MacroFab/Macro_Watch/Hardware/Eagle/README.md

###Macro_Watch Hardware
***
**Low cost, binary watch based off the PIC16F527 MCU for promotional purposes at MacroFab, INC.**

***
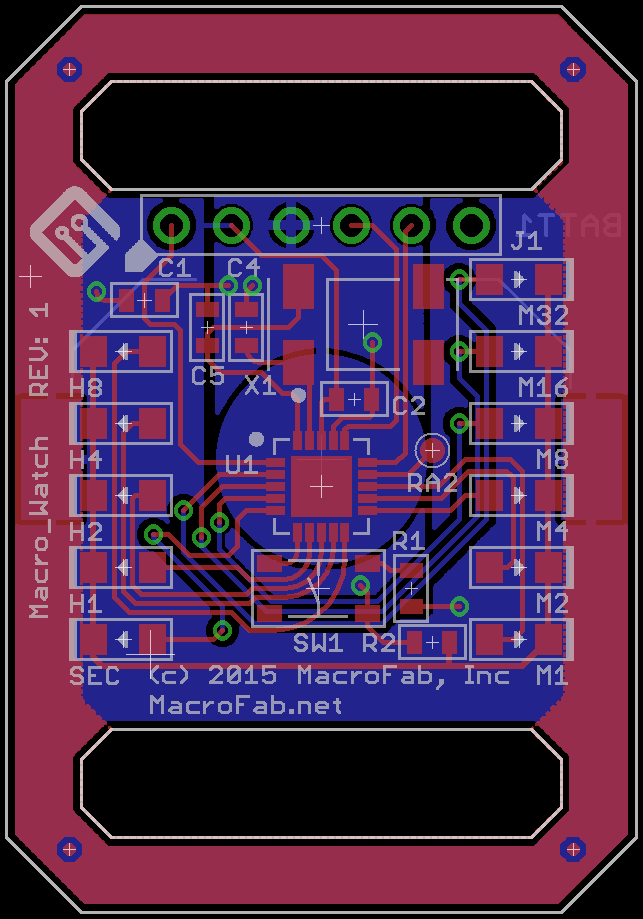
[picture p11: Hardware/Eagle/Layout.png]
Layout Image


***
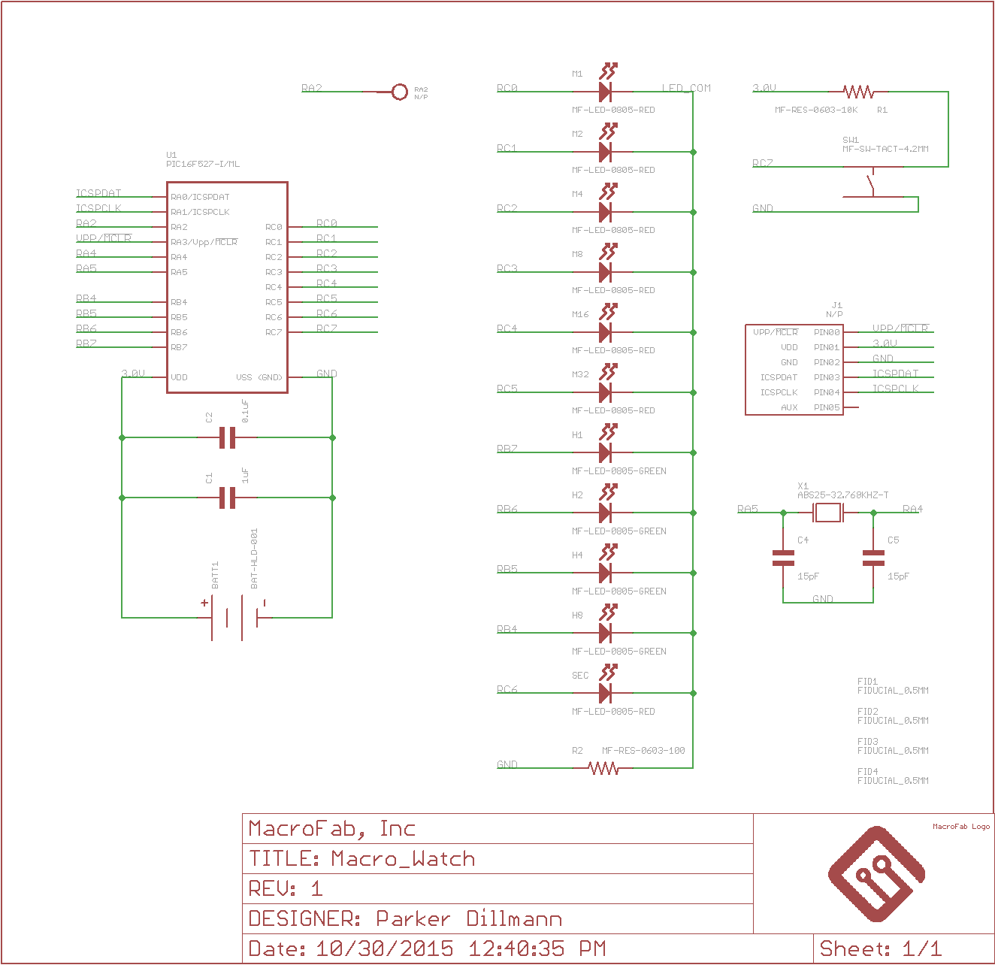
[picture p12: Hardware/Eagle/Schematic.png]
Schematic Image


***
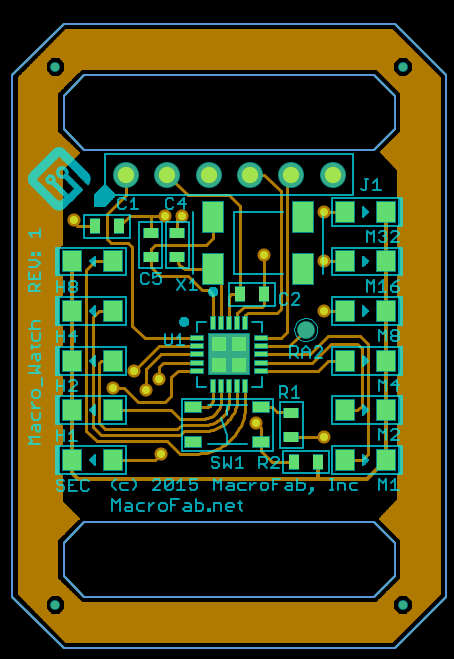
[picture p13: Hardware/Eagle/MacroWatch_gerber.png]
Gerber Top Drawing


Files are for Eagle V6.0+. Gerber files can be found in the camfiles directory. See main directory for licensing.
