MacroFab/Macro_Watch/(list of files, cad)

Other CAD files:
Software/MacroWatch.X/dist/default/production/MacroWatch.X.production.obj
