MacroFab/Macro_Watch/Hardware/Eagle/Macro_Watch.brd

## EAGLE design Hardware/Eagle/Macro_Watch.brd (2015-12-14)

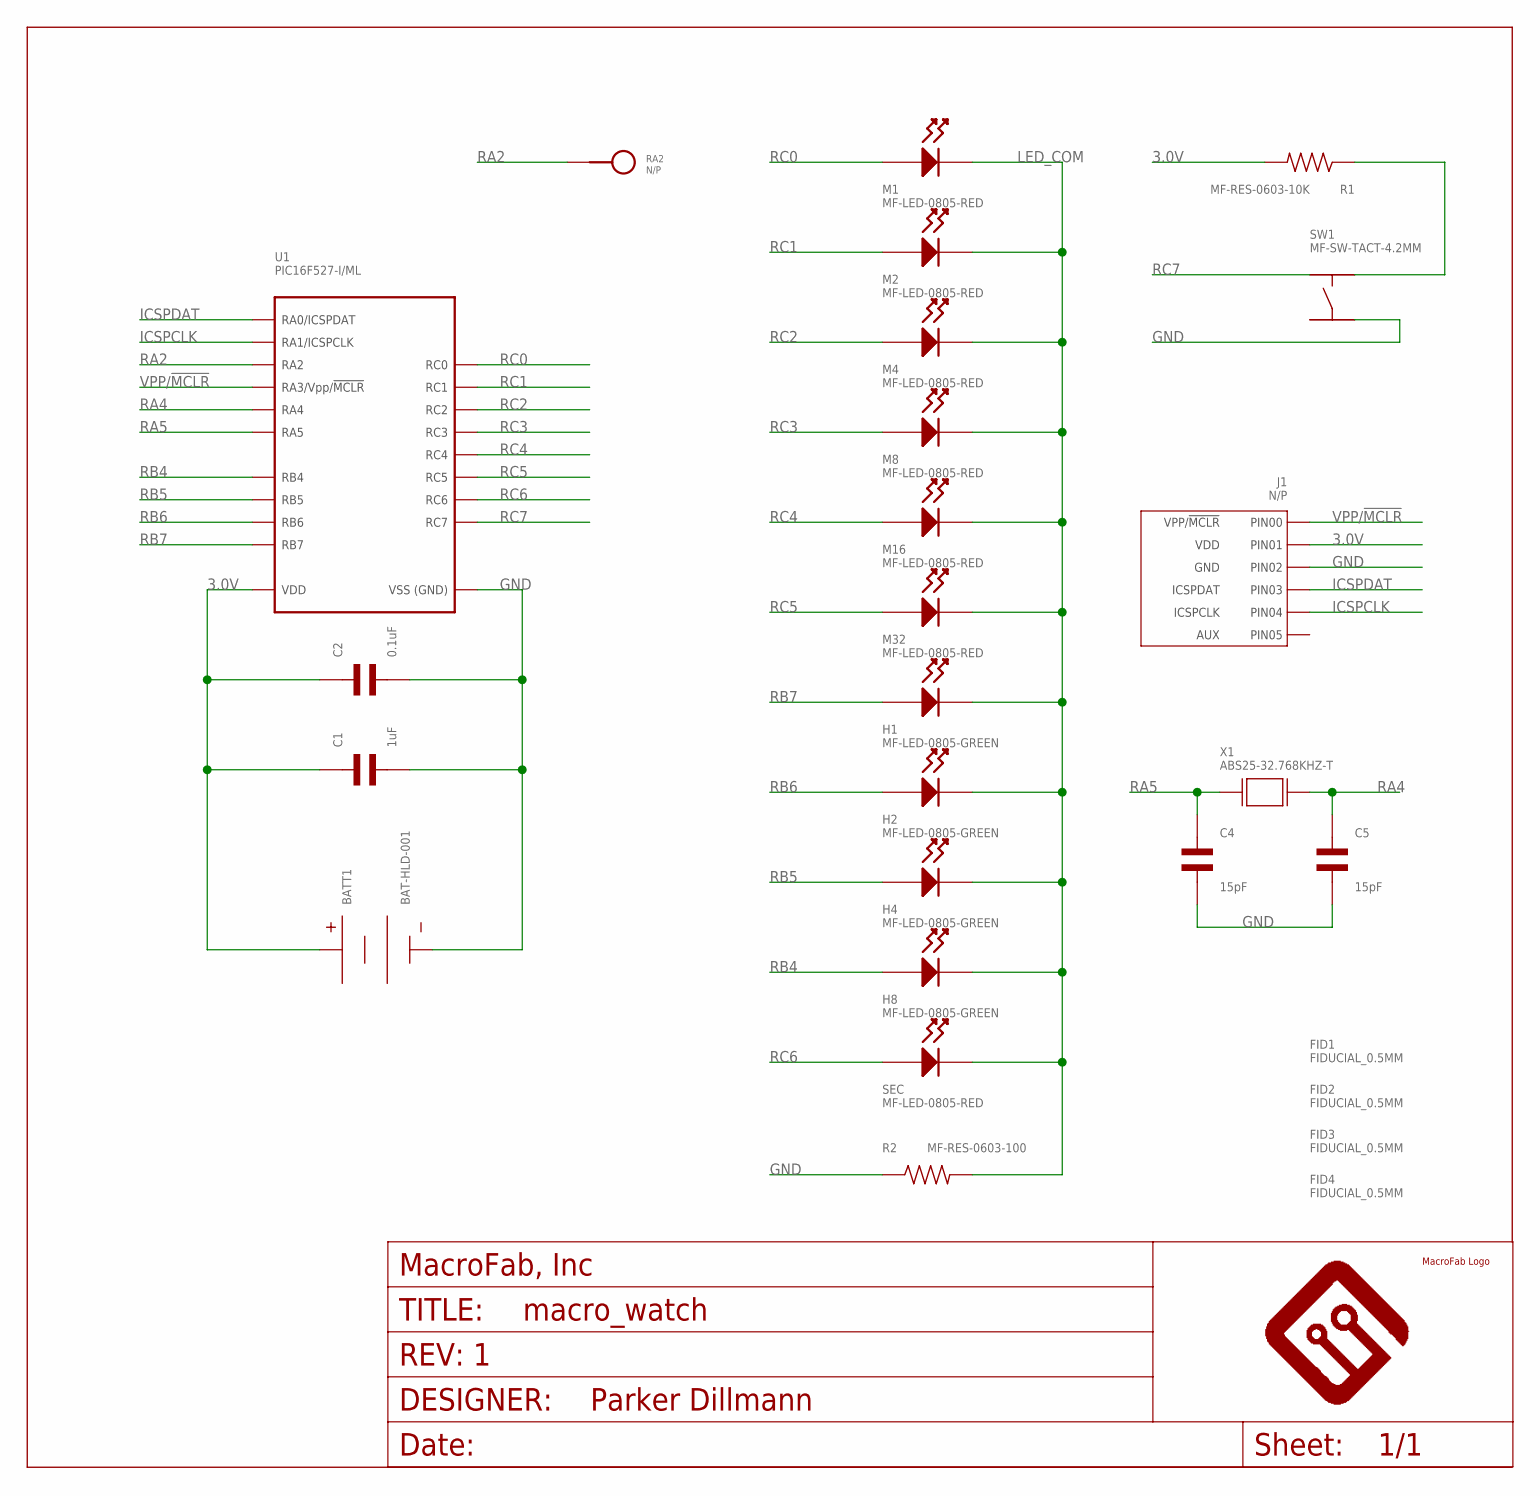
[picture p14: schematic Macro_Watch.sch]

Parts:
BATT1: BAT-HLD-001
C1: 1uF; C0603
C2: 0.1uF; C0603
C4, C5: 15pF; C0603
FID1, FID2, FID3, FID4: FIDUCIAL_0.5MM
FRAME1: MF_FRAMEDEFAULT; MF_FRAME_DEFAULT
H1, H2, H4, H8: MF-LED-0805-GREEN; LED0805
J1: N/P; PTH_2.54MM_01X06
M1, M2, M4, M8, M16, M32: MF-LED-0805-RED; LED0805
R1: MF-RES-0603-10K; R0603
R2: MF-RES-0603-100; R0603
RA2: N/P; ROUND_TP
SEC: MF-LED-0805-RED; LED0805
SW1: MF-SW-TACT-4.2MM; TACT4.2MM
U1: PIC16F527-I/ML; QFN20
U$1: MF_LOGOLOGO_SMALL; MF_LOGO_SMALL
X1: ABS25-32.768KHZ-T; ABS25_SERIES

Connections:
3.0V: BATT1.POS_0 (POS), BATT1.POS_1 (POS), C1.P$1, C2.P$1, J1.P$2 (PIN1), R1.P$2, U1.P$18 (VDD)
GND: BATT1.NEG_0 (NEG), C1.P$2, C2.P$2, C4.P$2, C5.P$2, J1.P$3 (PIN2), R2.P$1, SW1.P$4, U1.P$17 (GND)
ICSPCLK: J1.P$5 (PIN4), U1.P$15 (RA1/ICSPCLK)
ICSPDAT: J1.P$4 (PIN3), U1.P$16 (RA0/ICSPDAT)
LED_COM: H1.CATHODE, H2.CATHODE, H4.CATHODE, H8.CATHODE, M1.CATHODE, M2.CATHODE, M4.CATHODE, M8.CATHODE, M16.CATHODE, M32.CATHODE, R2.P$2, SEC.CATHODE
unnamed: R1.P$1, SW1.P$2
RA2: RA2.P$1, U1.P$14 (RA2)
RA4: C5.P$1, U1.P$20 (RA4), X1.4 (X1)
RA5: C4.P$1, U1.P$19 (RA5), X1.1 (X0)
RB4: H8.ANODE, U1.P$10 (RB4)
RB5: H4.ANODE, U1.P$9 (RB5)
RB6: H2.ANODE, U1.P$8 (RB6)
RB7: H1.ANODE, U1.P$7 (RB7)
RC0: M1.ANODE, U1.P$13 (RC0)
RC1: M2.ANODE, U1.P$12 (RC1)
RC2: M4.ANODE, U1.P$11 (RC2)
RC3: M8.ANODE, U1.P$4 (RC3)
RC4: M16.ANODE, U1.P$3 (RC4)
RC5: M32.ANODE, U1.P$2 (RC5)
RC6: SEC.ANODE, U1.P$5 (RC6)
RC7: SW1.P$1, U1.P$6 (RC7)
VPP/!MCLR: J1.P$1 (PIN0), U1.P$1 (RA3/VPP/!MCLR!)

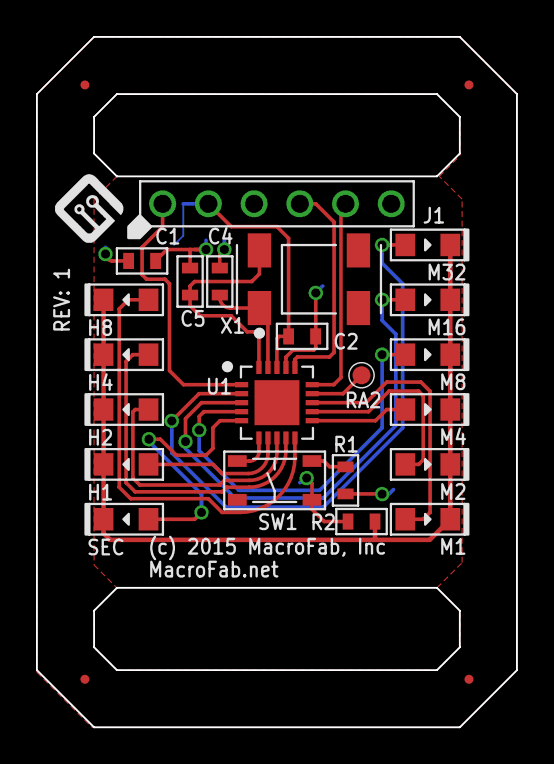
[picture p15: board Macro_Watch.brd from above]

Board: 2 copper layers, 26.7 x 38.4 mm, 29 parts (1 on the bottom side), 22 nets.
