MacroFab/Macro_Watch/Instruction Card.pdf

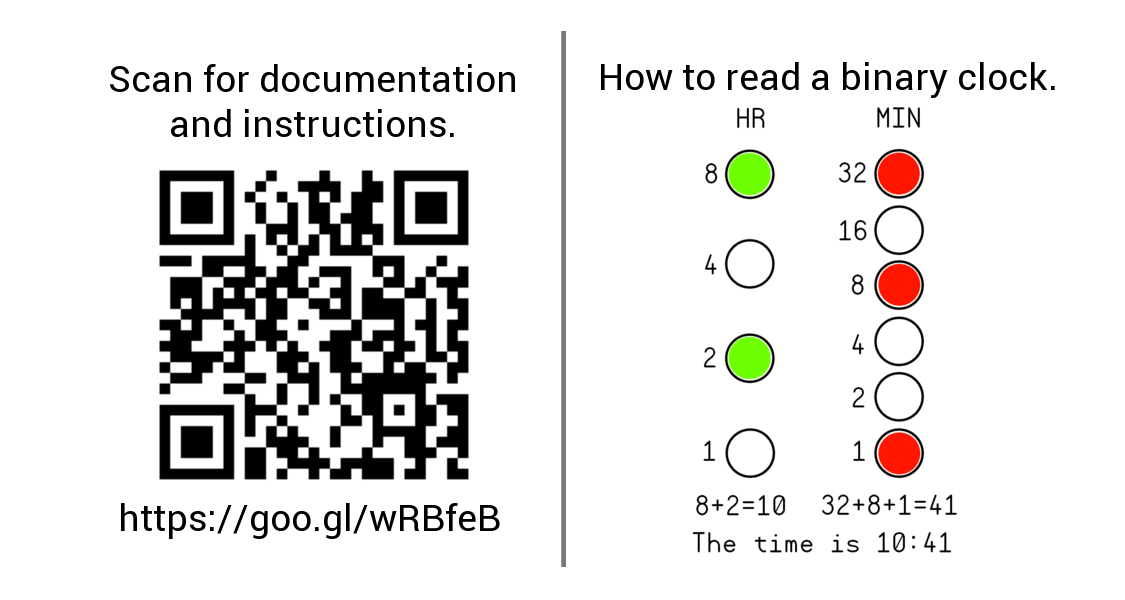
[picture p16: page 1]
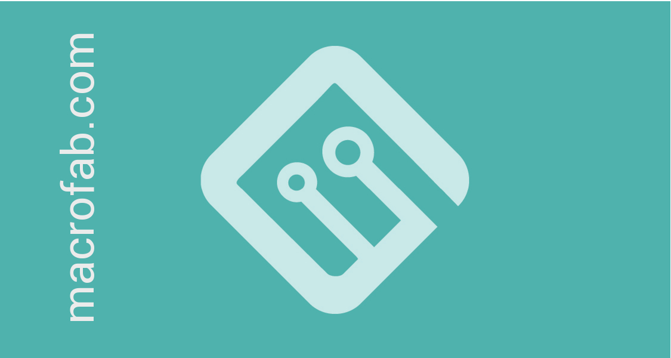
[picture p17: page 2]
