MacroFab/Macro_Watch/Software/MacroWatch.X/main.c

/*
 * File:   main.c
 * Author: Parker Dillmann
 *
 * Created on October 26, 2015, 4:07 PM
 */

#define _XTAL_FREQ 32768


// PIC16F527 Configuration Bit Settings

// 'C' source line config statements

#include <xc.h>

// #pragma config statements should precede project file includes.
// Use project enums instead of #define for ON and OFF.

// CONFIG
#pragma config FOSC = LP        // Oscillator Selection Interal
#pragma config WDTE = OFF       // Watchdog Timer Enable (WDT Disabled)
#pragma config CP = OFF         // Code Protection - User Program Memory (Code protection off)
#pragma config MCLRE = ON       // Master Clear Enable (MCLR pin functions as MCLR)
#pragma config IOSCFS = 8MHz    // Internal Oscillator Frequency Select (8 MHz INTOSC Speed)
#pragma config CPSW = OFF       // Code Protection - Self Writable Memory (Code protection off)
#pragma config BOREN = OFF      // Brown-out Reset Enable (BOR Enabled)
#pragma config DRTEN = OFF      // Device Reset Timer Enable (DRT Disabled)

#define HOURLED_0 RB7
#define HOURLED_1 RB6
#define HOURLED_2 RB5
#define HOURLED_3 RB4

#define MINLED_0  RC0
#define MINLED_1  RC1
#define MINLED_2  RC2
#define MINLED_3  RC3
#define MINLED_4  RC4
#define MINLED_5  RC5

#define SECOUT    RC6

#define SW        RC7

#define ISR       RA2

void TEST_LED_PATTERN(void);
void delay_ms(int);

char HOUR   = 3;
char MIN    = 6;
char SEC    = 0;
int INTCNT  = 0;

char Disp_timeout = 0;
char Change_time  = 0;
int  ADVCLKDELAY  = 0;      //How long till the minute counter is increased when changing the time.
int  ADVCLKCNT    = 0;      //How long till the value of the ADVCLKDELAY changes.

char BUTT_action = 0;

char STATE = 0;

void main(void) {
        
    CM1CON0 = 0x00; // These two registers must be zeroed out at the start to turn off comparators. 
    CM2CON0 = 0x00;
    OPTION = 0b11001000;
    ANSEL = 0x00;
    PORTA = 0x00;
    PORTB = 0x00;
    PORTC = 0x00;
    TRISA = 0x00;
    TRISB = 0x00;
    TRISC = 0x80;

    T0IE = 1;
    GIE=1;    
    
    TEST_LED_PATTERN();
        
    while (1)
    {
        switch(STATE)
        {
            //OFF STATE
            case 0:            
                PORTB = 0x00;
                PORTC = 0x00;
                
                if(SW == 0)
                {
                    STATE = 1;  
                    BUTT_action = 1;
                }
                else
                {
                    STATE = 0;
                    BUTT_action = 0;
                }
                break;
                
            //BUTTON PRESSED. RECORD TIME.
            case 1: 
                
                Disp_timeout = SEC; 
                Disp_timeout = Disp_timeout + 10;
                
                if(Disp_timeout >= 60)
                {
                    Disp_timeout = Disp_timeout - 60;
                }
                
                Change_time = SEC;
                Change_time = Change_time + 3; 
                
                if(Change_time >= 60)
                {
                    Change_time = Change_time - 60;
                }
                
                STATE = 2; 

                break;
            
            //TURN ON DISPLAY. AND WAIT FOR TIMEOUTS    
            case 2:
               
                HOURLED_0 = HOUR & 0b00000001;
                HOURLED_1 = (HOUR >> 1) & 0b00000001;
                HOURLED_2 = (HOUR >> 2) & 0b00000001;
                HOURLED_3 = (HOUR >> 3) & 0b00000001;
                
                MINLED_0  = MIN & 0b00000001; 
                MINLED_1  = (MIN >> 1) & 0b00000001; 
                MINLED_2  = (MIN >> 2) & 0b00000001;
                MINLED_3  = (MIN >> 3) & 0b00000001; 
                MINLED_4  = (MIN >> 4) & 0b00000001; 
                MINLED_5  = (MIN >> 5) & 0b00000001; 
                
                SECOUT    = SEC & 0b00000001; 
                
                
                //Display time out. Time to turn off display.
                if(Disp_timeout == SEC)
                {
                    STATE = 0;
                    BUTT_action == BUTT_action;
                }
                
                //Button is pressed again. Reset display time and set button action flag.
                else if(SW == 0 && BUTT_action == 0)
                {
                    STATE = 1;
                    BUTT_action = 1;
                }
                
                //Button is held for 3 seconds. Time to hack time!
                else if(Change_time == SEC && SW == 0 && BUTT_action == 1)
                {
                    STATE = 3;
                    BUTT_action == BUTT_action;
                    ADVCLKDELAY = 50;
                    ADVCLKCNT   = 2;
                }
                //Button has stopped being pressed. Clear button action flag.
                else if(SW == 1 && BUTT_action == 1)
                {
                    STATE = 2;
                    BUTT_action = 0; 
                }
                
                break;
              
            //INCREASE TIME AND DISPLAY TIME.    
            case 3:
                GIE = 0;
                
                //Switch held. Increase time.
                if(SW == 0)
                {
                    SEC = 0;
                    MIN = MIN + 1;
                    if(MIN == 60)
                    {
                        MIN = 0;
                        HOUR = HOUR + 1;
                        if(HOUR == 13)
                        {
                            HOUR = 1;   
                        }   
                    }
                    //Calculate "acceleration" of time hacking. 
                    ADVCLKCNT = ADVCLKCNT - 1;
                    if(ADVCLKCNT == 0 && ADVCLKDELAY > 5)
                    {
                        ADVCLKCNT = 3;
                        ADVCLKDELAY = ADVCLKDELAY - 5;
                    }
                   
                }    
                //Switch released. Recalculate on time. 
                else if(SW == 1)
                {
                    GIE = 1;
                    STATE = 1;
                }
                
                HOURLED_0 = HOUR & 0b00000001;
                HOURLED_1 = (HOUR >> 1) & 0b00000001;
                HOURLED_2 = (HOUR >> 2) & 0b00000001;
                HOURLED_3 = (HOUR >> 3) & 0b00000001;
                
                MINLED_0  = MIN & 0b00000001; 
                MINLED_1  = (MIN >> 1) & 0b00000001; 
                MINLED_2  = (MIN >> 2) & 0b00000001;
                MINLED_3  = (MIN >> 3) & 0b00000001; 
                MINLED_4  = (MIN >> 4) & 0b00000001; 
                MINLED_5  = (MIN >> 5) & 0b00000001; 
                
                delay_ms(ADVCLKDELAY);

                break;
            
                
            //Never supposed to get here but just encase of cosmic radiation flipping a bit.
            default:
                
                STATE = 0;
                
                break;   
        }

                
    }
    return;
}

void TEST_LED_PATTERN(void)
{
    GIE = 0;
    char mask = 0x01;
    
    for(int i = 0; i < 8; i++)
    {
        PORTB = mask;
        PORTC = mask;
        mask = mask << 1;
        __delay_ms(500);
    }
    GIE = 1;
    return;
}
 
void delay_ms(int milliseconds)
 {
   while(milliseconds > 0)
   {
       __delay_ms(10);
      milliseconds--;
    }
 }

void interrupt isr(void)
{
    ISR = 1;
    INTCNT = INTCNT + 1;
    if(INTCNT == 32)
    {  
        INTCNT = 0; 
        SEC = SEC + 1;
        
        if (SEC == 60)
        {
            SEC = 0;
            MIN = MIN + 1;
            if (MIN == 60)
            {
                MIN = 0;
                HOUR = HOUR + 1;
                if(HOUR == 13)
                {
                    HOUR = 1;
                } 
            } 
        }
    }
    ISR = 0;
    T0IF = 0;
    return;
}
