MacroFab/Macro_Watch/(commit log)

2015-10-28 First push of hardware.
    [Macro_Watch.brd, Macro_Watch.sch]
2015-10-28 Tweaked back side silkscreen
    [Macro_Watch.brd]
2015-10-30 Added working camfiles and tweaked layout.
    Added a TP for RA2 pin on MCU. Gerber files have been checked and are
    ready for production.
    [Macro_Watch.GBL, Macro_Watch.GBO, Macro_Watch.GBP, Macro_Watch.GBS, Macro_Watch.GTL, Macro_Watch.GTO, Macro_Watch.GTP, Macro_Watch.GTS]
2015-10-30 Adding Gerber image.
2015-11-03 Added code. Beta software.
    [MacroWatch.X.production.obj, MicrochipTest.X.production.obj]
2015-11-09 Finished release code.
    [MacroWatch.X.production.obj]
2015-11-13 Updating pictures and README with documentation.
    [MicrochipTest.X.production.obj]
2015-11-13 Added Assembly Pictures.
2015-12-14 Updated TP to latest Library Style.
    [Macro_Watch.brd, Macro_Watch.sch]
2016-02-12 Adding more EDA Tool support.
    [Macro_Watch.GBL, Macro_Watch.GBO, Macro_Watch.GBP, Macro_Watch.GBS, Macro_Watch.GTL, Macro_Watch.GTO, Macro_Watch.GTP, Macro_Watch.GTS]
