MacroFab/Macro_Watch/(notices)

Notices in the files:
parts and their libraries:
MF_Aesthetics: (c) 2015 MacroFab, Inc
